TheJigsApp/lumenpnp/clearance.scad

use <openscad-utilities/rounded_rectangle.scad>;

rounded_rectangle(101,101, 5);

$fn=128;
