TheJigsApp/lumenpnp/pnp/pcb/mobo/RS485.kicad_sch

## KiCad design pnp/pcb/mobo/RS485.kicad_sch (2025-06-10)

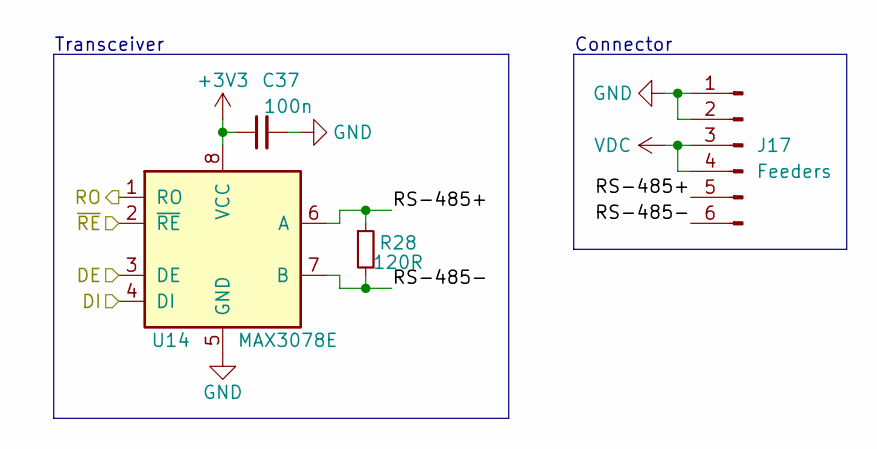
[picture p1: schematic RS485.kicad_sch]

Parts:
C37: 100n; C_0805_2012Metric; Digikey 1276-1180-1-ND
J17: Feeders; IDC-Header_2x03_P2.54mm_Vertical; LCSC C601936
R28: 120R; R_0805_2012Metric; Digikey 541-120CCT-ND
U14: MAX3078E; SOIC-8_3.9x4.9mm_P1.27mm; LCSC C40031

Connections:
+3V3: C37.1, U14.8 (VCC)
DE: U14.3 (DE)
DI: U14.4 (DI)
GND: C37.2, J17.1, J17.2, U14.5 (GND)
RO: U14.1 (RO)
RS-485+: J17.5, R28.1, U14.6 (A)
RS-485-: J17.6, R28.2, U14.7 (B)
VDC: J17.3, J17.4
~RE: U14.2 (~RE)

Notes on the sheet:
Transceiver
Connector
