TheJigsApp/lumenpnp/pnp/pcb/mobo/lighting.kicad_sch

## KiCad design pnp/pcb/mobo/lighting.kicad_sch (2025-06-10)

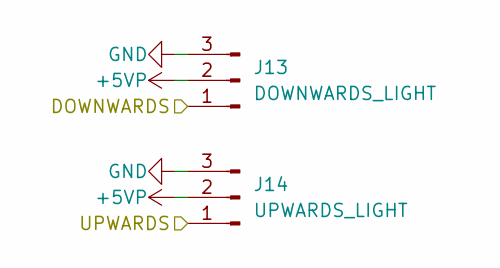
[picture p3: schematic lighting.kicad_sch]

Parts:
J13: DOWNWARDS_LIGHT; JST_XH_B3B-XH-A_1x03_P2.50mm_Vertical; LCSC C2316
J14: UPWARDS_LIGHT; JST_XH_B3B-XH-A_1x03_P2.50mm_Vertical; LCSC C2316

Connections:
+5VP: J13.2, J14.2
DOWNWARDS: J13.1
GND: J13.3, J14.3
UPWARDS: J14.1
