TheJigsApp/lumenpnp/pnp/pcb/mobo/microcontroller.kicad_sch

## KiCad design pnp/pcb/mobo/microcontroller.kicad_sch (2025-06-10)

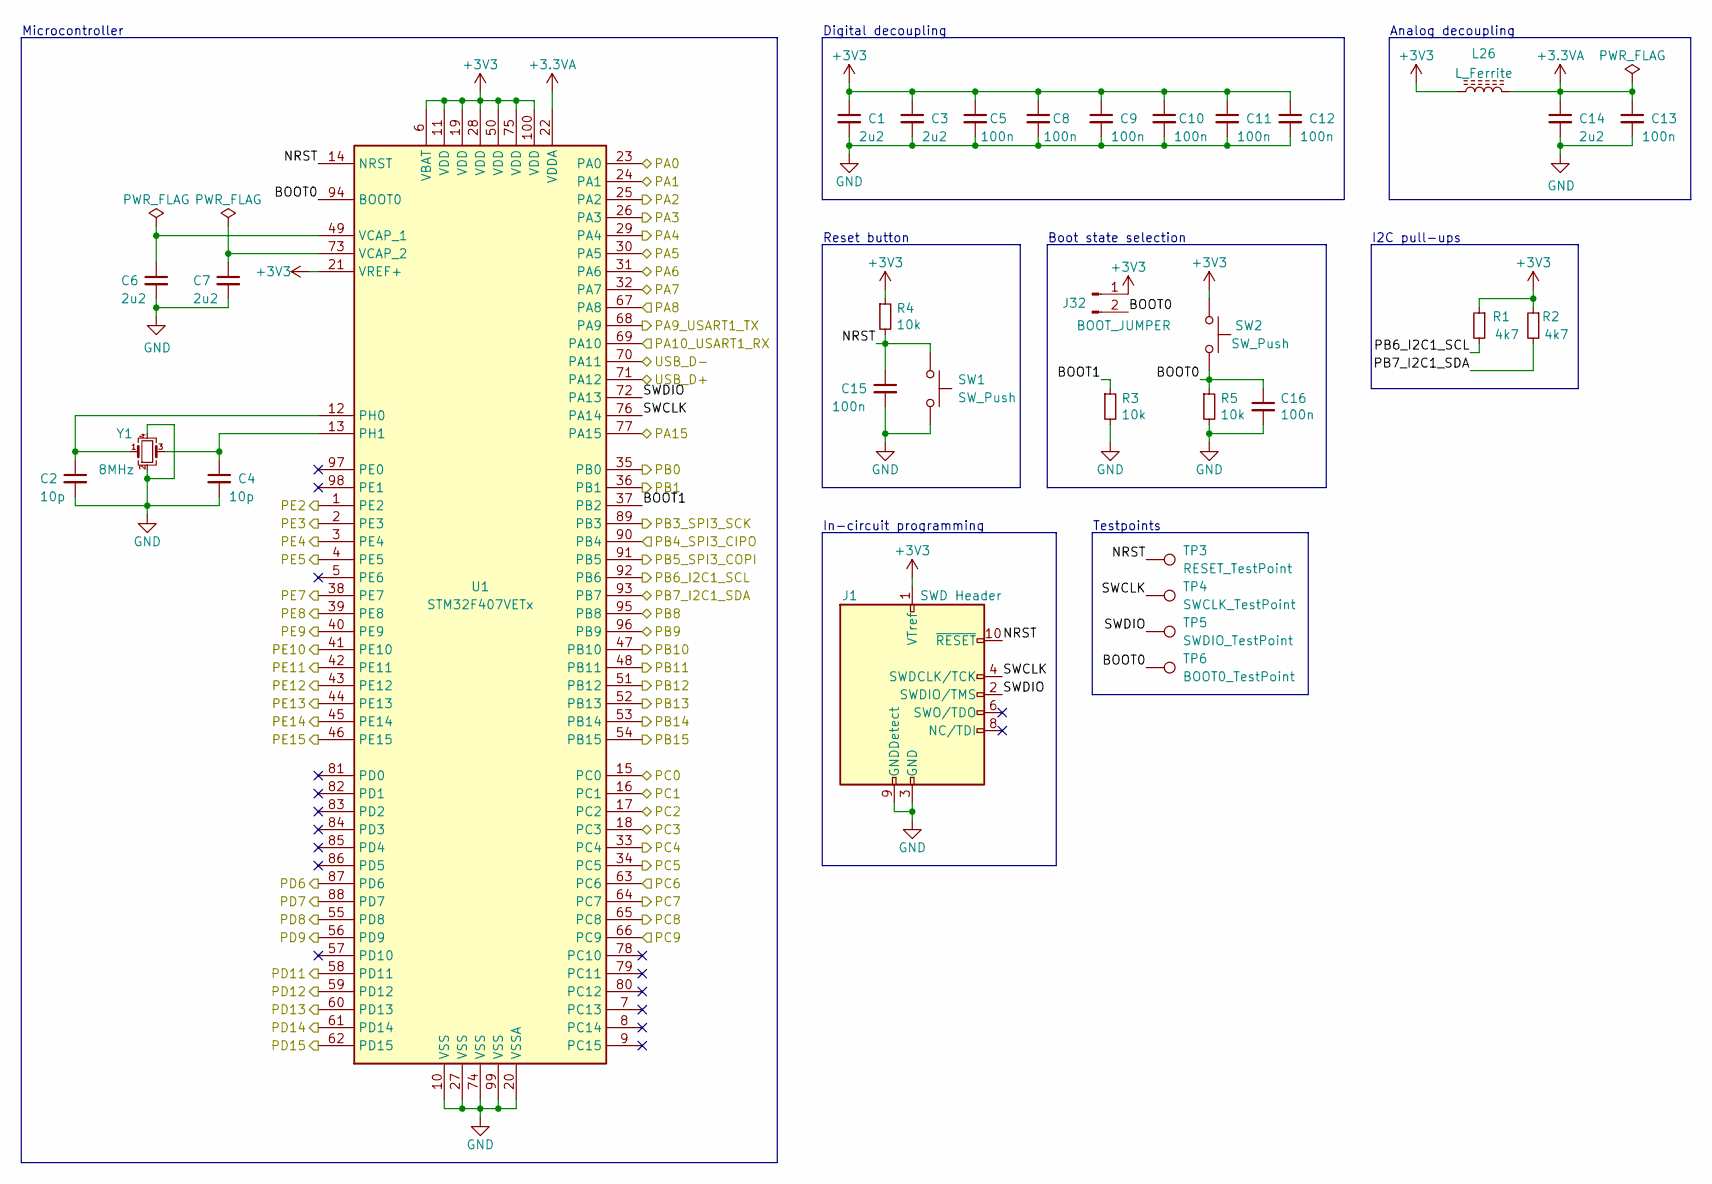
[picture p5: schematic microcontroller.kicad_sch]

Parts:
C1, C3, C6, C7, C14: 2u2; C_0805_2012Metric; Digikey 587-4961-1-ND
C2, C4: 10p; C_0805_2012Metric; JLCPCB C1785
C5, C8, C9, C10, C11, C12, C13, C15, C16: 100n; C_0805_2012Metric; Digikey 1276-1180-1-ND
J1: SWD Header; PinHeader_2x05_P1.27mm_Vertical_SMD; LCSC C150517
J32: BOOT_JUMPER; PinHeader_1x02_P2.54mm_Vertical
L26: L_Ferrite; L_0805_2012Metric; Digikey 1934-1472-1-ND
R1, R2: 4k7; R_0805_2012Metric; Digikey A129757CT-ND
R3, R4, R5: 10k; R_0805_2012Metric; Digikey RMCF0805FT10K0CT-ND
SW1, SW2: SW_Push; SW_SPST_B3S-1000; JLCPCB C83206
TP3: RESET_TestPoint; TestPoint_Pad_D2.0mm
TP4: SWCLK_TestPoint; TestPoint_Pad_D2.0mm
TP5: SWDIO_TestPoint; TestPoint_Pad_D2.0mm
TP6: BOOT0_TestPoint; TestPoint_Pad_D2.0mm
U1: STM32F407VETx; LQFP-100_14x14mm_P0.5mm; Digikey 497-12075-ND
Y1: 8MHz; Crystal_SMD_3225-4Pin_3.2x2.5mm; JLCPCB C57131

Connections:
+3.3VA: C13.1, C14.1, L26.2, U1.22 (VDDA)
+3V3: C1.1, C3.1, C5.1, C8.1, C9.1, C10.1, C11.1, C12.1, J1.1 (VTref), J32.1, L26.1, R1.1, R2.1, R4.1, SW2.2, U1.6 (VBAT), U1.11 (VDD), U1.19 (VDD), U1.21 (VREF+), U1.28 (VDD), U1.50 (VDD), U1.75 (VDD), U1.100 (VDD)
BOOT0: C16.1, J32.2, R5.1, SW2.1, TP6.1, U1.94 (BOOT0)
BOOT1: R3.1, U1.37 (PB2)
GND: C1.2, C2.2, C3.2, C4.2, C5.2, C6.2, C7.2, C8.2, C9.2, C10.2, C11.2, C12.2, C13.2, C14.2, C15.2, C16.2, J1.3 (GND), J1.5 (GND), J1.9 (GNDDetect), R3.2, R5.2, SW1.1, U1.10 (VSS), U1.20 (VSSA), U1.27 (VSS), U1.74 (VSS), U1.99 (VSS), Y1.2, Y1.4
NRST: C15.1, J1.10 (~RESET), R4.2, SW1.2, TP3.1, U1.14 (NRST)
unnamed: C2.1, U1.12 (PH0), Y1.1
unnamed: C4.1, U1.13 (PH1), Y1.3
unnamed: C6.1, U1.49 (VCAP_1)
unnamed: C7.1, U1.73 (VCAP_2)
PA0: U1.23 (PA0)
PA1: U1.24 (PA1)
PA2: U1.25 (PA2)
PA3: U1.26 (PA3)
PA4: U1.29 (PA4)
PA5: U1.30 (PA5)
PA6: U1.31 (PA6)
PA7: U1.32 (PA7)
PA8: U1.67 (PA8)
PA9_USART1_TX: U1.68 (PA9)
PA10_USART1_RX: U1.69 (PA10)
PA15: U1.77 (PA15)
PB0: U1.35 (PB0)
PB1: U1.36 (PB1)
PB3_SPI3_SCK: U1.89 (PB3)
PB4_SPI3_CIPO: U1.90 (PB4)
PB5_SPI3_COPI: U1.91 (PB5)
PB6_I2C1_SCL: R1.2, U1.92 (PB6)
PB7_I2C1_SDA: R2.2, U1.93 (PB7)
PB8: U1.95 (PB8)
PB9: U1.96 (PB9)
PB10: U1.47 (PB10)
PB11: U1.48 (PB11)
PB12: U1.51 (PB12)
PB13: U1.52 (PB13)
PB14: U1.53 (PB14)
PB15: U1.54 (PB15)
PC0: U1.15 (PC0)
PC1: U1.16 (PC1)
PC2: U1.17 (PC2)
PC3: U1.18 (PC3)
PC4: U1.33 (PC4)
PC5: U1.34 (PC5)
PC6: U1.63 (PC6)
PC7: U1.64 (PC7)
PC8: U1.65 (PC8)
PC9: U1.66 (PC9)
PD6: U1.87 (PD6)
PD7: U1.88 (PD7)
PD8: U1.55 (PD8)
PD9: U1.56 (PD9)
PD11: U1.58 (PD11)
PD12: U1.59 (PD12)
PD13: U1.60 (PD13)
PD14: U1.61 (PD14)
PD15: U1.62 (PD15)
PE2: U1.1 (PE2)
PE3: U1.2 (PE3)
PE4: U1.3 (PE4)
PE5: U1.4 (PE5)
PE7: U1.38 (PE7)
PE8: U1.39 (PE8)
PE9: U1.40 (PE9)
PE10: U1.41 (PE10)
PE11: U1.42 (PE11)
PE12: U1.43 (PE12)
PE13: U1.44 (PE13)
PE14: U1.45 (PE14)
PE15: U1.46 (PE15)
SWCLK: J1.4 (SWDCLK/TCK), TP4.1, U1.76 (PA14)
SWDIO: J1.2 (SWDIO/TMS), TP5.1, U1.72 (PA13)
USB_D+: U1.71 (PA12)
USB_D-: U1.70 (PA11)

Notes on the sheet:
Analog decoupling
Reset button
Microcontroller
Boot state selection
Digital decoupling
Testpoints
In-circuit programming
I2C pull-ups
