TheJigsApp/lumenpnp/pnp/pcb/mobo/miscellaneous.kicad_sch

## KiCad design pnp/pcb/mobo/miscellaneous.kicad_sch (2025-06-10)

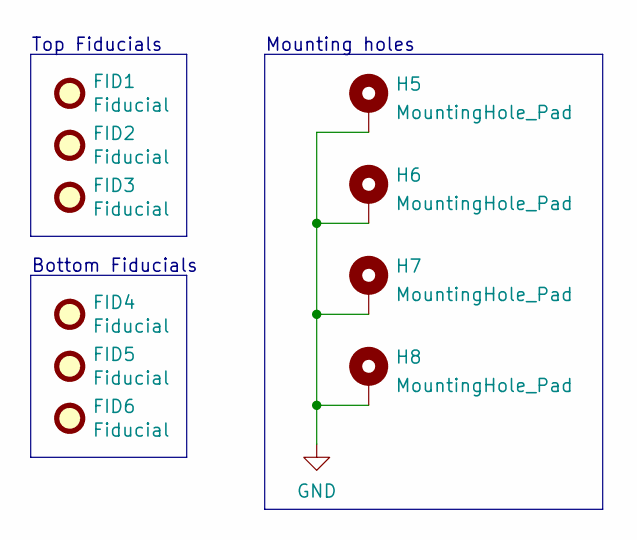
[picture p6: schematic miscellaneous.kicad_sch]

Parts:
FID1, FID2, FID3, FID4, FID5, FID6: Fiducial; Fiducial_1mm_Mask2mm
H5, H6, H7, H8: MountingHole_Pad; MountingHole_3.2mm_M3_DIN965_Pad

Connections:
GND: H5.1, H6.1, H7.1, H8.1

Notes on the sheet:
Bottom Fiducials
Top Fiducials
Mounting holes
