TheJigsApp/lumenpnp/pnp/pcb/mobo/mosfet.kicad_sch

## KiCad design pnp/pcb/mobo/mosfet.kicad_sch (2025-06-10)

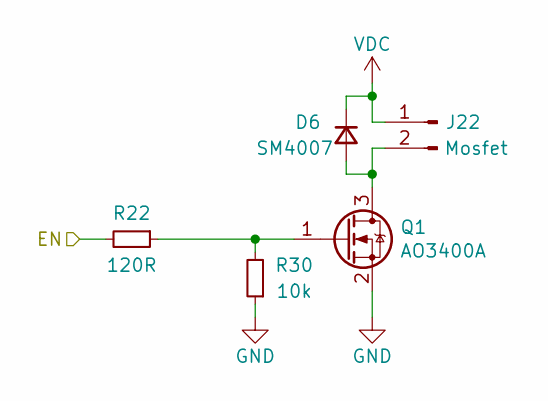
[picture p7: schematic mosfet.kicad_sch]

Parts:
D6: SM4007; D_SOD-123F; JLCPCB C64898
J22: Mosfet; JST_XH_B2B-XH-A_1x02_P2.50mm_Vertical; JLCPCB C20079
Q1: AO3400A; SOT-23; Mouser 942-IRLML6344TRPBF
R22: 120R; R_0805_2012Metric; JLCPCB C4360
R30: 10k; R_0805_2012Metric; JLCPCB C4360

Connections:
EN: R22.2
GND: Q1.2 (S), R30.1
unnamed: D6.2 (A), J22.2, Q1.3 (D)
unnamed: Q1.1 (G), R22.1, R30.2
VDC: D6.1 (K), J22.1
