TheJigsApp/lumenpnp/pnp/pcb/mobo/power.kicad_sch

## KiCad design pnp/pcb/mobo/power.kicad_sch (2025-06-10)

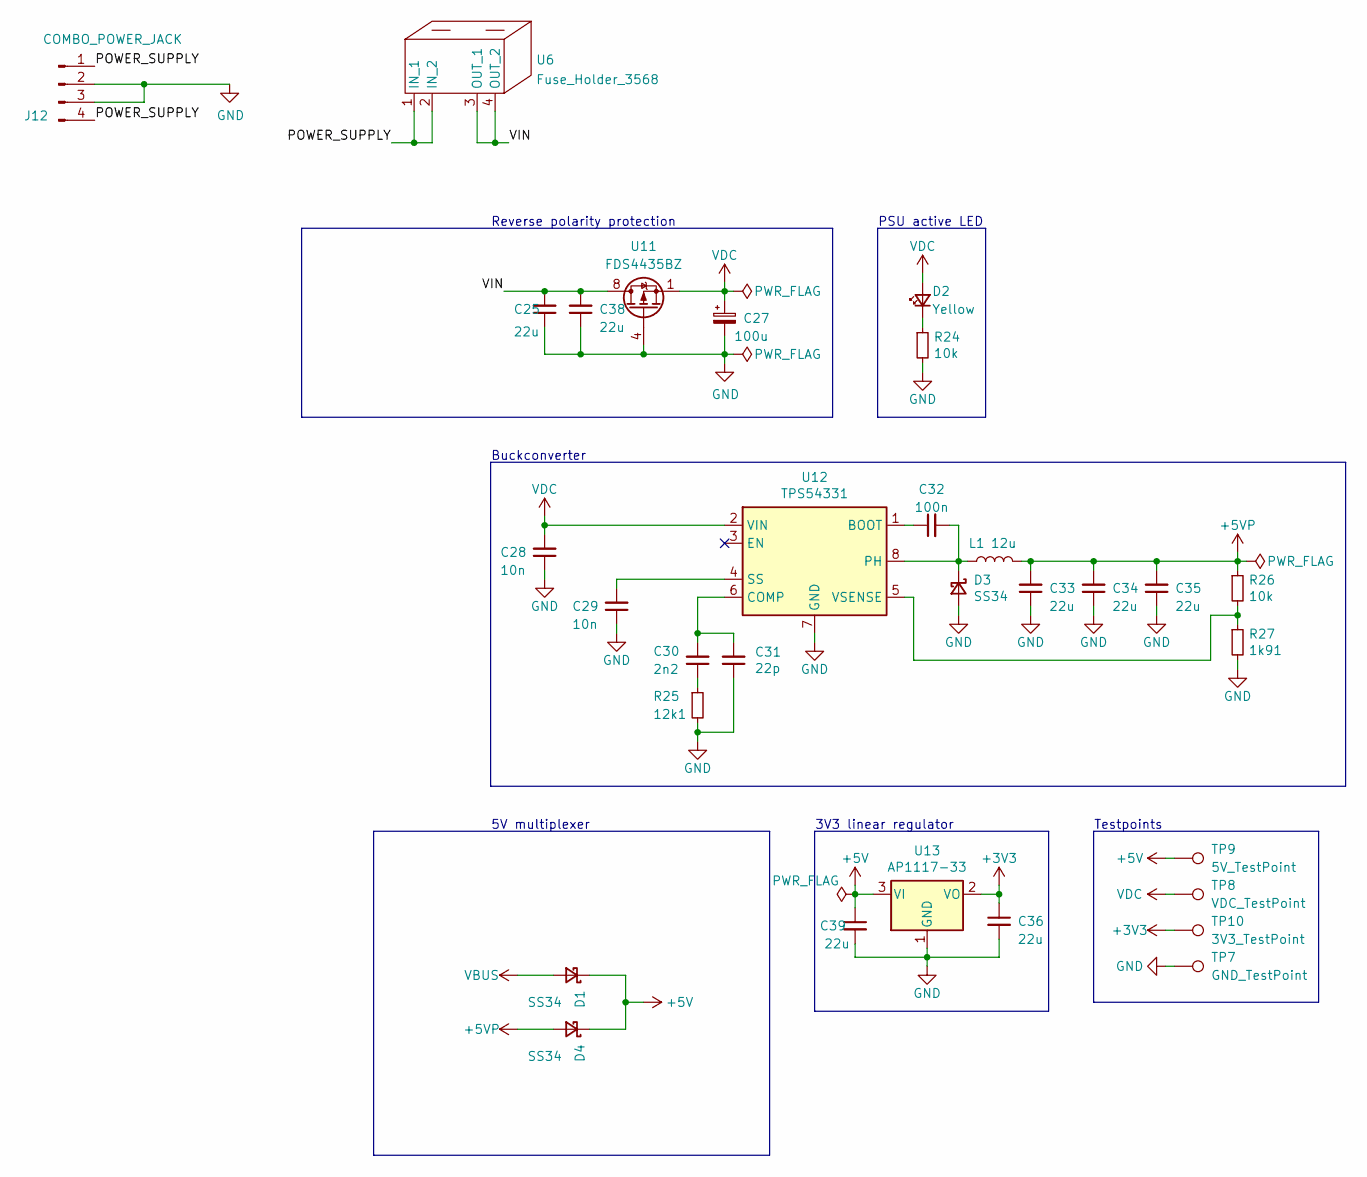
[picture p8: schematic power.kicad_sch]

Parts:
C25, C33, C34, C35, C38: 22u; C_0805_2012Metric; JLCPCB C45783
C27: 100u; CP_Elec_6.3x7.7; Digikey 493-2203-1-ND
C28, C29: 10n; C_0805_2012Metric; Digikey 1276-1015-1-ND
C30: 2n2; C_0805_2012Metric; Digikey 1276-2993-1-ND
C31: 22p; C_0805_2012Metric; Digikey 311-1103-1-ND
C32: 100n; C_0805_2012Metric; Digikey 1276-1180-1-ND
C36, C39: 22u; C_0805_2012Metric; JLCPCB C15850
D1, D3, D4: SS34; D_SMA; LCSC C266553
D2: Yellow; LED_0805_2012Metric; Digikey 732-4987-1-ND
J12: COMBO_POWER_JACK; BarrelJack_Horizontal; Digikey CP-102A-ND
L1: 12u; L_Coilcraft_XAL60xx_6.36x6.56mm; Digikey ASPI-6045S-120M-TCT-ND
R24, R26: 10k; R_0805_2012Metric; Digikey RMCF0805FT10K0CT-ND
R25: 12k1; R_0805_2012Metric; JLCPCB C17431
R27: 1k91; R_0805_2012Metric; Digikey 541-1.91KCCT-ND
TP7: GND_TestPoint; TestPoint_Pad_D2.0mm
TP8: VDC_TestPoint; TestPoint_Pad_D2.0mm
TP9: 5V_TestPoint; TestPoint_Pad_D2.0mm
TP10: 3V3_TestPoint; TestPoint_Pad_D2.0mm
U6: Fuse_Holder_3568; Digikey 36-3568-ND
U11: FDS4435BZ; SO-8_3.9x4.9mm_P1.27mm; JLCPCB C23931
U12: TPS54331; SOIC-8_3.9x4.9mm_P1.27mm; LCSC C9865
U13: AP1117-33; SOT-223-3_TabPin2; JLCPCB C108785

Connections:
+3V3: C36.1, TP10.1, U13.2 (VO)
+5V: C39.1, D1.1 (K), D4.1 (K), TP9.1, U13.3 (VI)
+5VP: C33.2, C34.2, C35.2, D4.2 (A), L1.2, R26.1
GND: C25.1, C27.2, C28.1, C29.1, C31.1, C33.1, C34.1, C35.1, C36.2, C38.1, C39.2, D3.2 (A), J12.2, J12.3, R24.2, R25.2, R27.2, TP7.1, U11.4 (G), U12.7 (GND), U13.1 (GND)
unnamed: C29.2, U12.4 (SS)
unnamed: C30.1, R25.1
unnamed: C30.2, C31.2, U12.6 (COMP)
unnamed: C32.1, U12.1 (BOOT)
unnamed: C32.2, D3.1 (K), L1.1, U12.8 (PH)
unnamed: D2.1 (K), R24.1
unnamed: R26.2, R27.1, U12.5 (VSENSE)
POWER_SUPPLY: J12.1, J12.4, U6.1 (IN_1), U6.2 (IN_2)
VBUS: D1.2 (A)
VDC: C27.1, C28.2, D2.2 (A), TP8.1, U11.1 (S), U11.2 (S), U11.3 (S), U12.2 (VIN)
VIN: C25.2, C38.2, U6.3 (OUT_1), U6.4 (OUT_2), U11.5 (D), U11.6 (D), U11.7 (D), U11.8 (D)

Notes on the sheet:
Buckconverter
Reverse polarity protection
Testpoints
PSU active LED
3V3 linear regulator
5V multiplexer
