TheJigsApp/lumenpnp/pnp/pcb/mobo/single_motor.kicad_sch

## KiCad design pnp/pcb/mobo/single_motor.kicad_sch (2025-06-10)

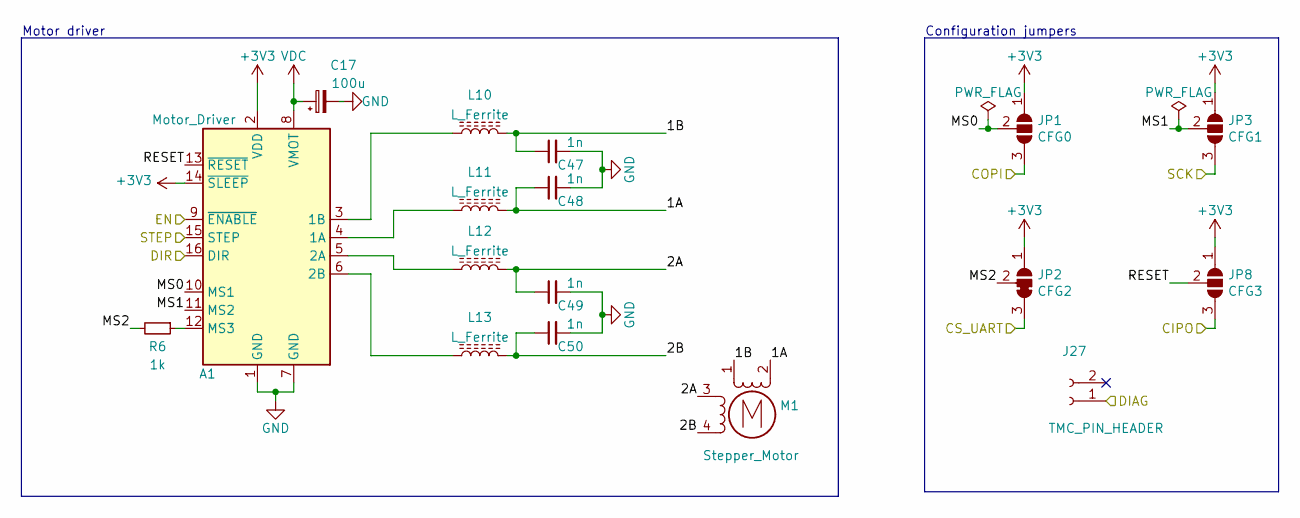
[picture p10: schematic single_motor.kicad_sch]

Parts:
A1: Motor_Driver; Pololu_Breakout-16_15.2x20.3mm; Digikey 1460-TMC2209SILENTSTEPSTICK-ND
C17: 100u; CP_Elec_6.3x7.7; Digikey 493-2203-1-ND
C47, C48, C49, C50: 1n; C_0805_2012Metric; Digikey 1276-1020-1-ND
J27: TMC_PIN_HEADER; PinSocket_1x02_P2.54mm_Vertical
JP1: CFG0; SolderJumper-3_P1.3mm_Open_RoundedPad1.0x1.5mm
JP2: CFG2; SolderJumper-3_P1.3mm_Bridged23_RoundedPad1.0x1.5mm
JP3: CFG1; SolderJumper-3_P1.3mm_Open_RoundedPad1.0x1.5mm
JP8: CFG3; SolderJumper-3_P1.3mm_Open_RoundedPad1.0x1.5mm
L10, L11, L12, L13: L_Ferrite; L_0805_2012Metric; Digikey 1934-1472-1-ND
M1: Stepper_Motor; JST_XH_B4B-XH-A_1x04_P2.50mm_Vertical; LCSC C37815
R6: 1k; R_0805_2012Metric; JLCPCB C17513

Connections:
1A: C48.1, L11.2, M1.2 (-)
1B: C47.1, L10.2, M1.1
2A: C49.1, L12.2, M1.3
2B: C50.1, L13.2, M1.4
+3V3: A1.2 (VDD), A1.14 (~SLEEP), JP1.1 (A), JP2.1 (B), JP3.1 (A), JP8.1 (A)
CIPO: JP8.3 (B)
COPI: JP1.3 (B)
CS_UART: JP2.3 (A)
DIAG: J27.1
DIR: A1.16 (DIR)
EN: A1.9 (~ENABLE)
GND: A1.1 (GND), A1.7 (GND), C17.2, C47.2, C48.2, C49.2, C50.2
MS0: A1.10 (MS1), JP1.2 (C)
MS1: A1.11 (MS2), JP3.2 (C)
MS2: JP2.2 (C), R6.2
unnamed: A1.3 (1B), L10.1
unnamed: A1.4 (1A), L11.1
unnamed: A1.5 (2A), L12.1
unnamed: A1.6 (2B), L13.1
unnamed: A1.12 (MS3), R6.1
RESET: A1.13 (~RESET), JP8.2 (C)
SCK: JP3.3 (B)
STEP: A1.15 (STEP)
VDC: A1.8 (VMOT), C17.1

Notes on the sheet:
Motor driver
Configuration jumpers
