TheJigsApp/lumenpnp/(commit log)

2024-01-05 adding kicad make build and jigsapp layers. Combining board outline into a polygon
    [clearance.scad, design-input.xlsx, points.xlsx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]
2024-07-14 removing test jig
    [design-input.xlsx, points.xlsx, points_out.xlsx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]
2025-06-10 porting version
    [RS485.kicad_sch, aux_header.kicad_sch, aux_headers.kicad_sch, dual_motors.kicad_sch, lighting.kicad_sch, limit_switches.kicad_sch, microcontroller.kicad_sch, miscellaneous.kicad_sch]
